Kevinnan-teen/MCU-Projects-Collection/README.md

# 单片机项目合集

## 1、排队叫号系统设计

类似食堂取餐的模式。首先，学生排队，服务员使用键盘给顾客分配号码，按下确定键，数码管显示当前队列中的人数、刚刚进入队列的号码，并通过串口通信的方式将队列人数和当前分配的号码发送给从机，从机将数据显示在1602液晶屏上。另外，主机通过键盘按键选择取餐功能，按下出队键，叫到要取餐的号码，并通过语音播报取餐号码。

[更多详细内容](./Queue_System)

proteus仿真实例



### ToDo

- 51单片机编程常用数据结构、算法实现（队列、链表...，排序）
- 51单片机核心板（AD 原理图+pcb设计、焊接）
- 万年历（pcb+3D打印，作息时间控制）
