Kevinnan-teen/MCU-Projects-Collection/Queue_System/resources/4位数码管引脚.png

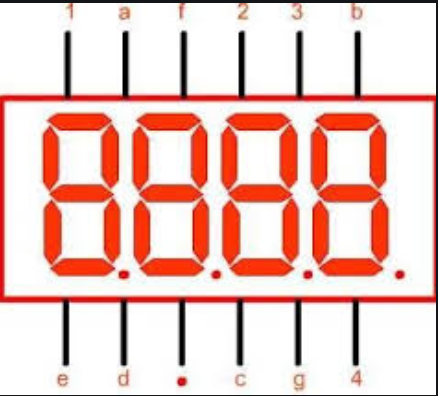
Queue_System/resources/4位数码管引脚.png
