Kevinnan-teen/MCU-Projects-Collection/Queue_System/resources/proteus仿真.png

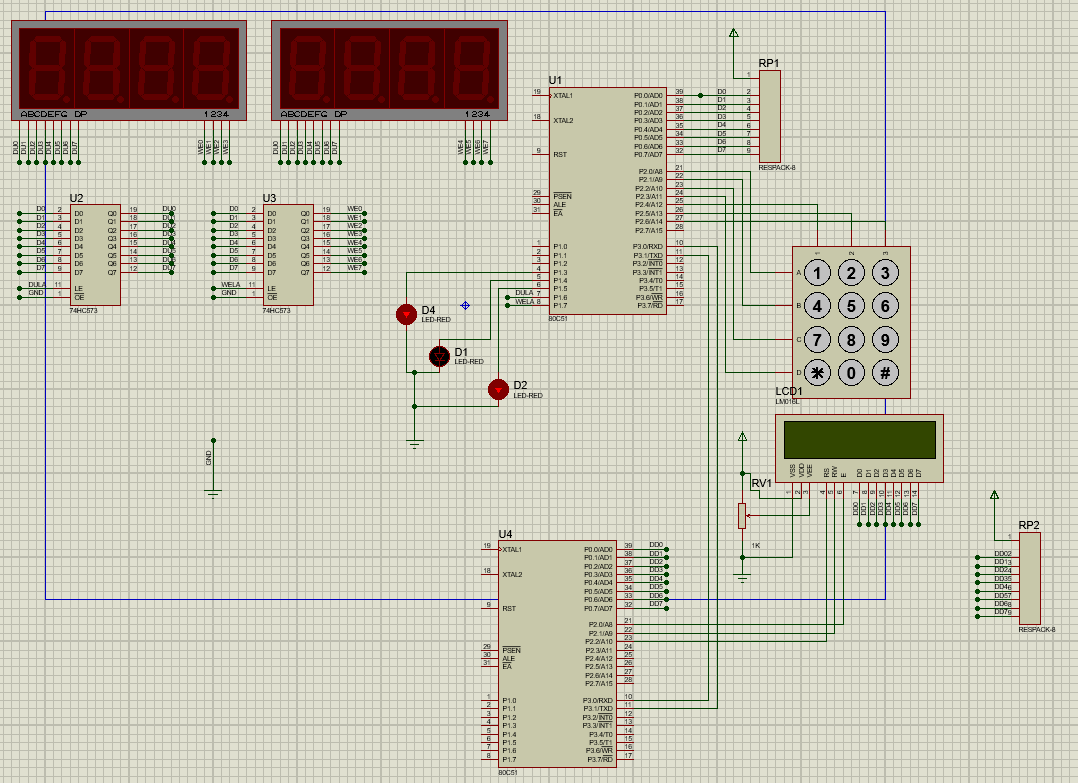
Queue_System/resources/proteus仿真.png
