Kevinnan-teen/MCU-Projects-Collection/Queue_System/resources/排队叫号系统面包板连接图_1.png

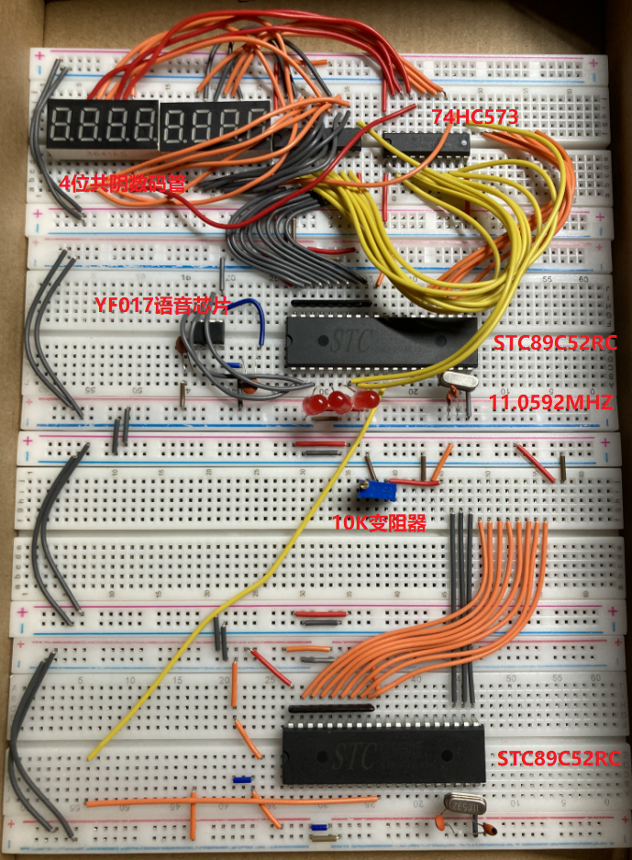
Queue_System/resources/排队叫号系统面包板连接图_1.png
