Kevinnan-teen/MCU-Projects-Collection/(list of files, drawings)

Other design files:
Queue_System/QueueSystem_proteus_simulation/QueueSystem.pdsprj
