Kevinnan-teen/MCU-Projects-Collection/(commit log)

2021-03-15 添加资源文件；芯片数据手册，电路原理图
2021-03-15 添加主机/从机代码
2021-03-15 Proteus仿真电路
    [QueueSystem.pdsprj]
2021-03-15 添加硬件实物演示和Proteus仿真演示
2021-03-15 添加资源图片
